hmbusch/PCB-Designs/Pixel/etching-template/pixel.png

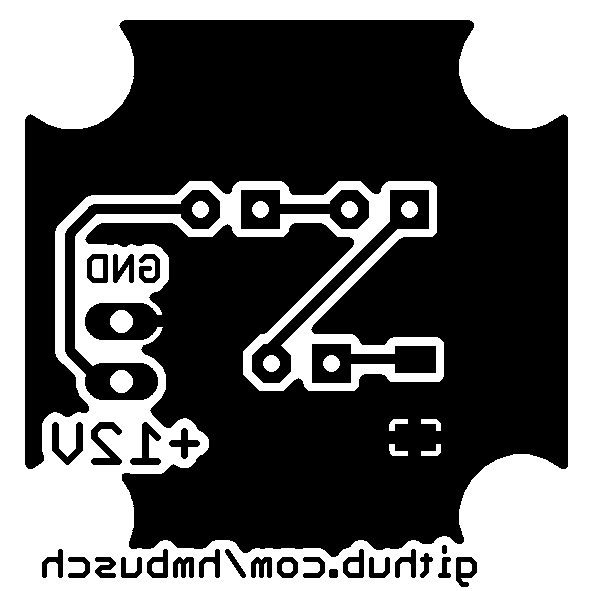
Pixel/etching-template/pixel.png
