hmbusch/PCB-Designs/SMD-Breakouts/images/g3528-plcc2-led-breakout.tif

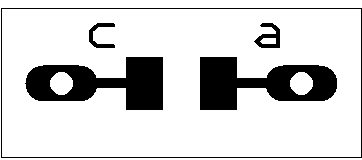
SMD-Breakouts/images/g3528-plcc2-led-breakout.tif
