hmbusch/PCB-Designs/SMD-Breakouts/images/so14-breakout.tif

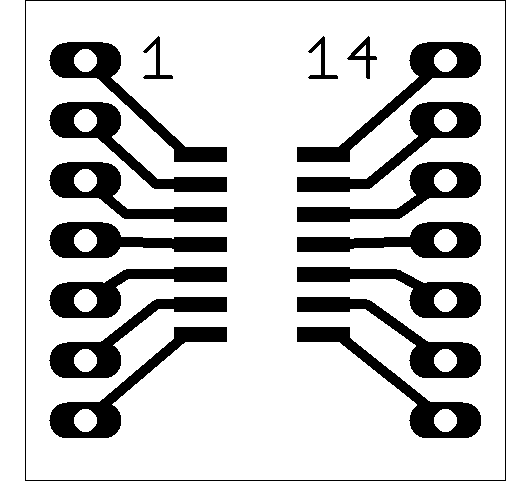
SMD-Breakouts/images/so14-breakout.tif
