hmbusch/PCB-Designs/kicad-3dmodels/alps-skrk-series-smd-push-button.step

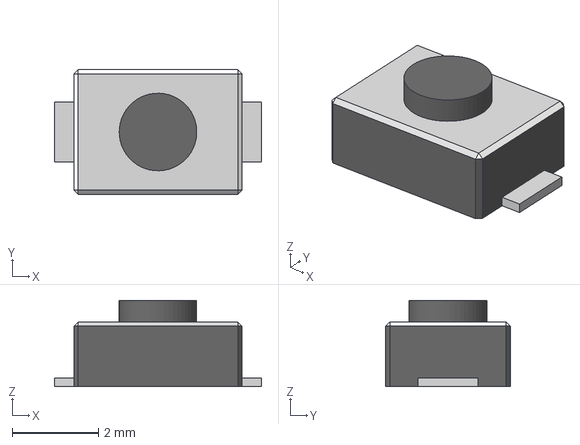
[picture p4: CAD file, 2024-10-26]
kicad-3dmodels/alps-skrk-series-smd-push-button.step
4.80 x 2.90 x 2.00 mm
