hmbusch/PCB-Designs/ChainableScrew595/ChainableScrew595.pdf

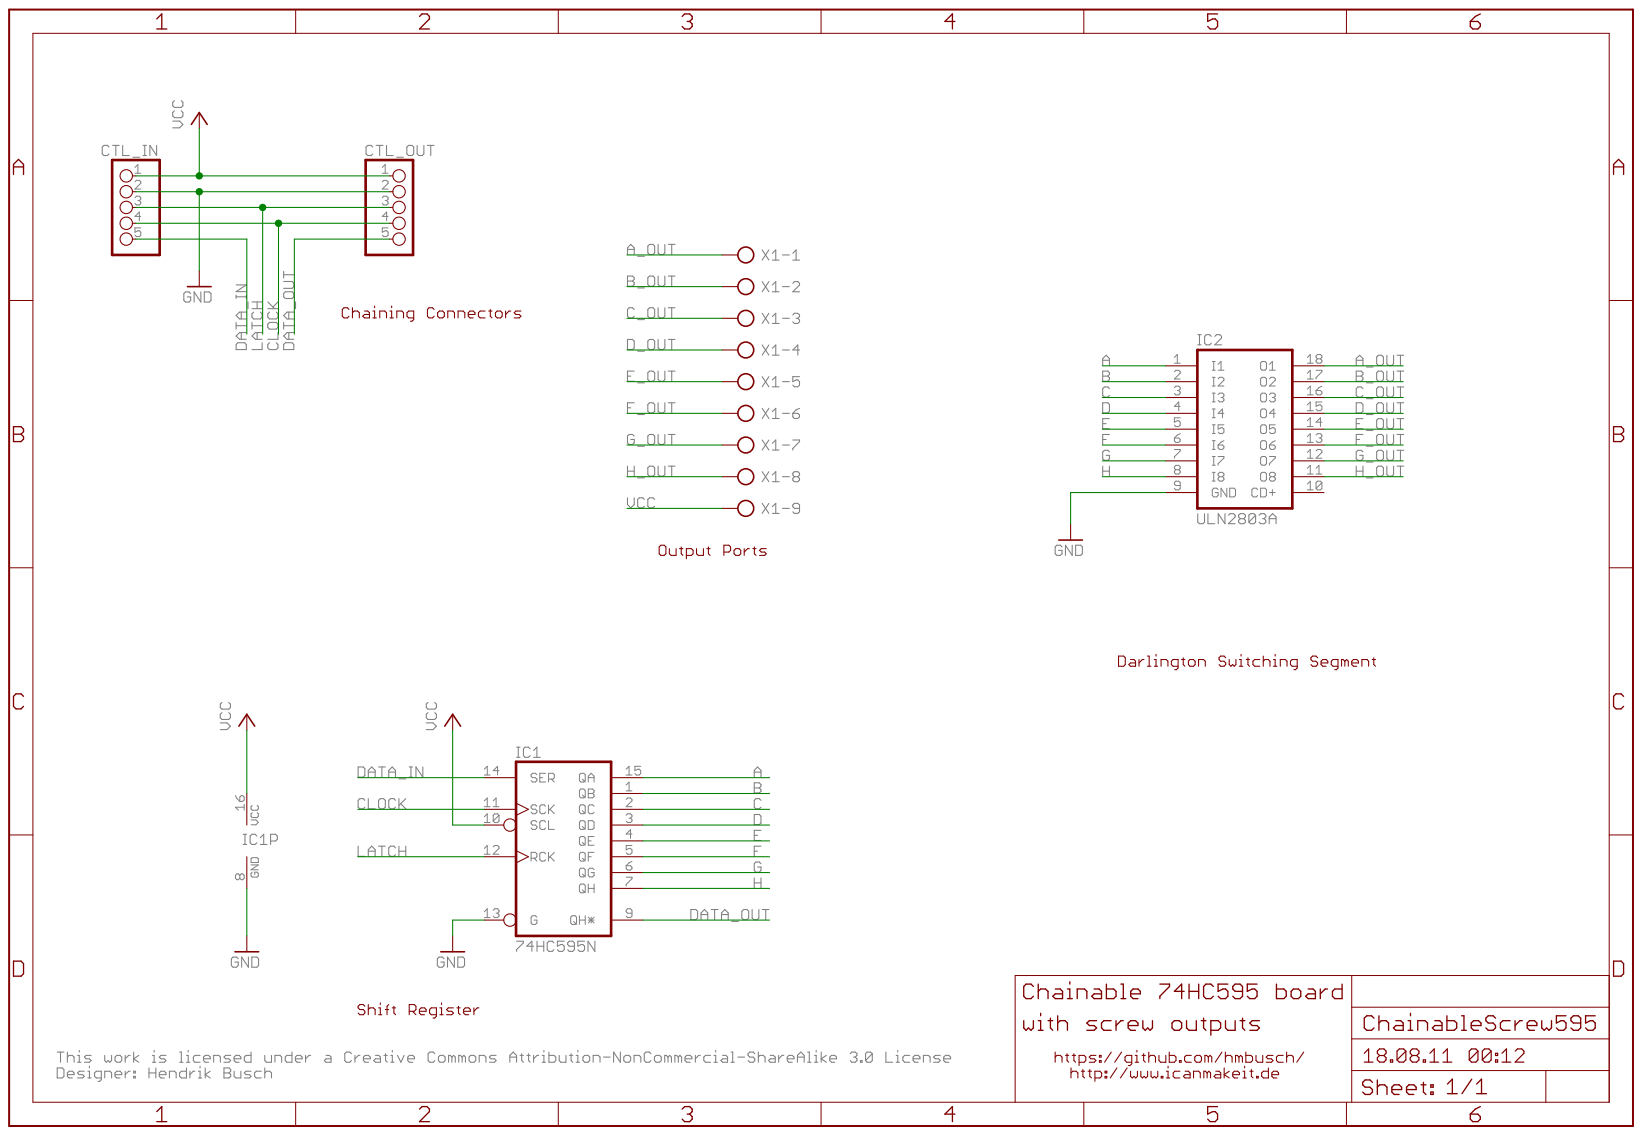
[picture p5: page 1]
