hmbusch/PCB-Designs/wemos-d1-mini-mainboard/wemos-d1-mini-mainboard.kicad_pcb

## KiCad design wemos-d1-mini-mainboard/wemos-d1-mini-mainboard.kicad_pcb (2023-09-02)

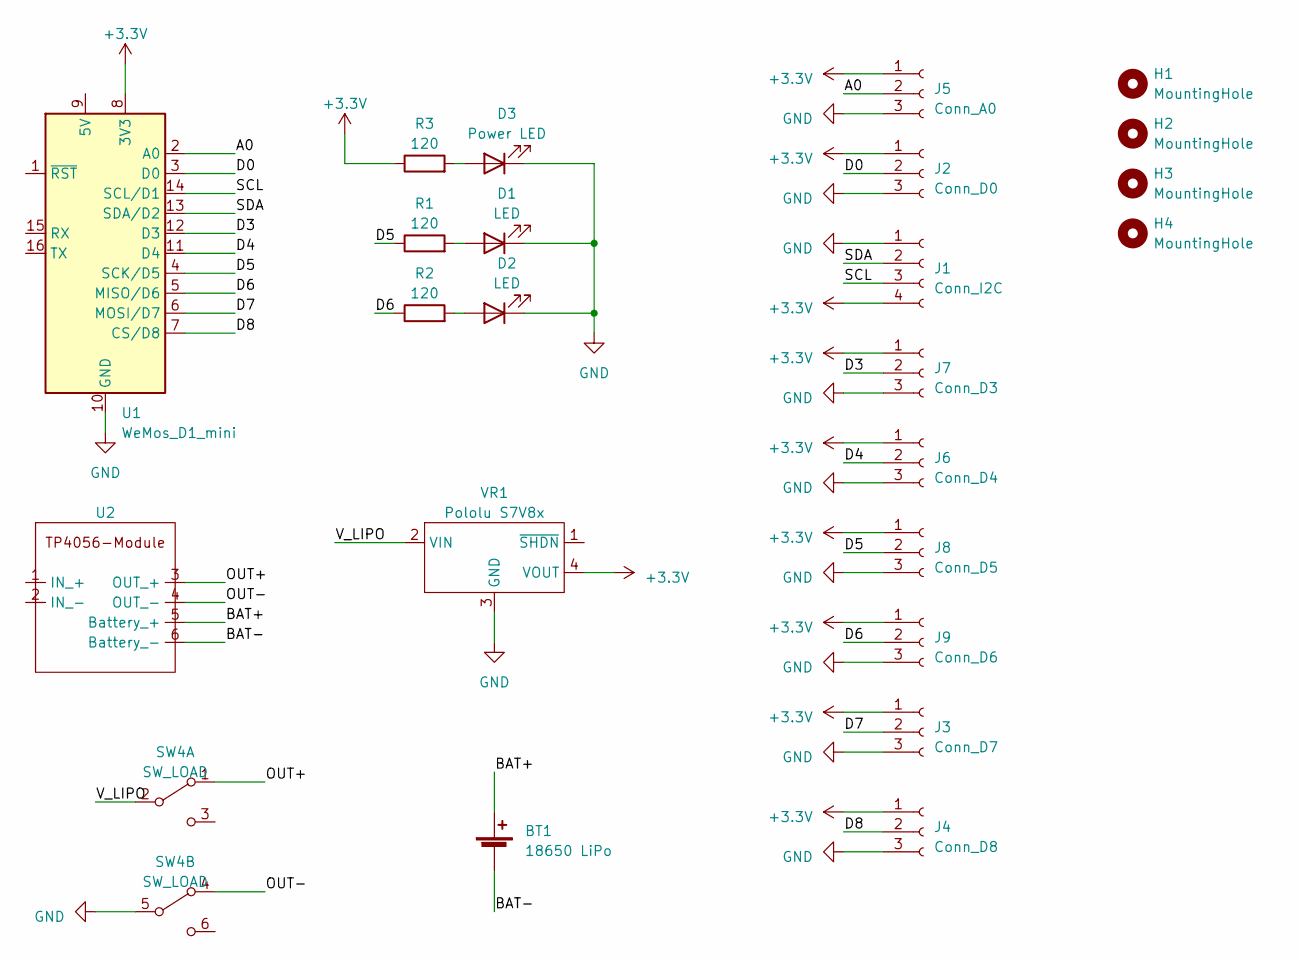
[picture p6: schematic wemos-d1-mini-mainboard.kicad_sch]

Parts:
BT1: 18650 LiPo; BatteryHolder_Keystone_1042_1x18650_different_silkscreen
D1, D2: LED; LED_SMD_3528_1411
D3: Power LED; LED_SMD_3528_1411
H1, H2, H3, H4: MountingHole; MountingHole_3.2mm_M3
J1: Conn_I2C; Molex_KK-254_AE-6410-04A_1x04_P2.54mm_Vertical
J2: Conn_D0; Molex_KK-254_AE-6410-03A_1x03_P2.54mm_Vertical
J3: Conn_D7; Molex_KK-254_AE-6410-03A_1x03_P2.54mm_Vertical
J4: Conn_D8; Molex_KK-254_AE-6410-03A_1x03_P2.54mm_Vertical
J5: Conn_A0; Molex_KK-254_AE-6410-03A_1x03_P2.54mm_Vertical
J6: Conn_D4; Molex_KK-254_AE-6410-03A_1x03_P2.54mm_Vertical
J7: Conn_D3; Molex_KK-254_AE-6410-03A_1x03_P2.54mm_Vertical
J8: Conn_D5; Molex_KK-254_AE-6410-03A_1x03_P2.54mm_Vertical
J9: Conn_D6; Molex_KK-254_AE-6410-03A_1x03_P2.54mm_Vertical
R1, R2, R3: 120; R_1206_3216Metric_Pad1.30x1.75mm_HandSolder
SW4: SW_LOAD; SK22D07_DPDT_slide_switch
U1: WeMos_D1_mini; WEMOS_D1_mini_light
U2: TP4056-Module
VR1: Pololu S7V8x; Pololu S7V8x Voltage Regulator

Connections:
+3.3V: J1.4, J2.1, J3.1, J4.1, J5.1, J6.1, J7.1, J8.1, J9.1, R3.1, U1.8 (3V3), VR1.4 (VOUT)
/A0: J5.2, U1.2 (A0)
/BAT+: BT1.1 (+), U2.5 (Battery_+)
/BAT-: BT1.2 (-), U2.6 (Battery_-)
/D0: J2.2, U1.3 (D0)
/D3: J7.2, U1.12 (D3)
/D4: J6.2, U1.11 (D4)
/D5: J8.2, R1.1, U1.4 (SCK/D5)
/D6: J9.2, R2.1, U1.5 (MISO/D6)
/D7: J3.2, U1.6 (MOSI/D7)
/D8: J4.2, U1.7 (CS/D8)
/OUT+: SW4.1 (A), U2.3 (OUT_+)
/OUT-: SW4.4 (A), U2.4 (OUT_-)
/SCL: J1.3, U1.14 (SCL/D1)
/SDA: J1.2, U1.13 (SDA/D2)
/V_LIPO: SW4.2 (B), VR1.2 (VIN)
GND: D1.1 (K), D2.1 (K), D3.1 (K), J1.1, J2.3, J3.3, J4.3, J5.3, J6.3, J7.3, J8.3, J9.3, SW4.5 (B), U1.10 (GND), VR1.3 (GND)
unnamed: D1.2 (A), R1.2
unnamed: D2.2 (A), R2.2
unnamed: D3.2 (A), R3.2

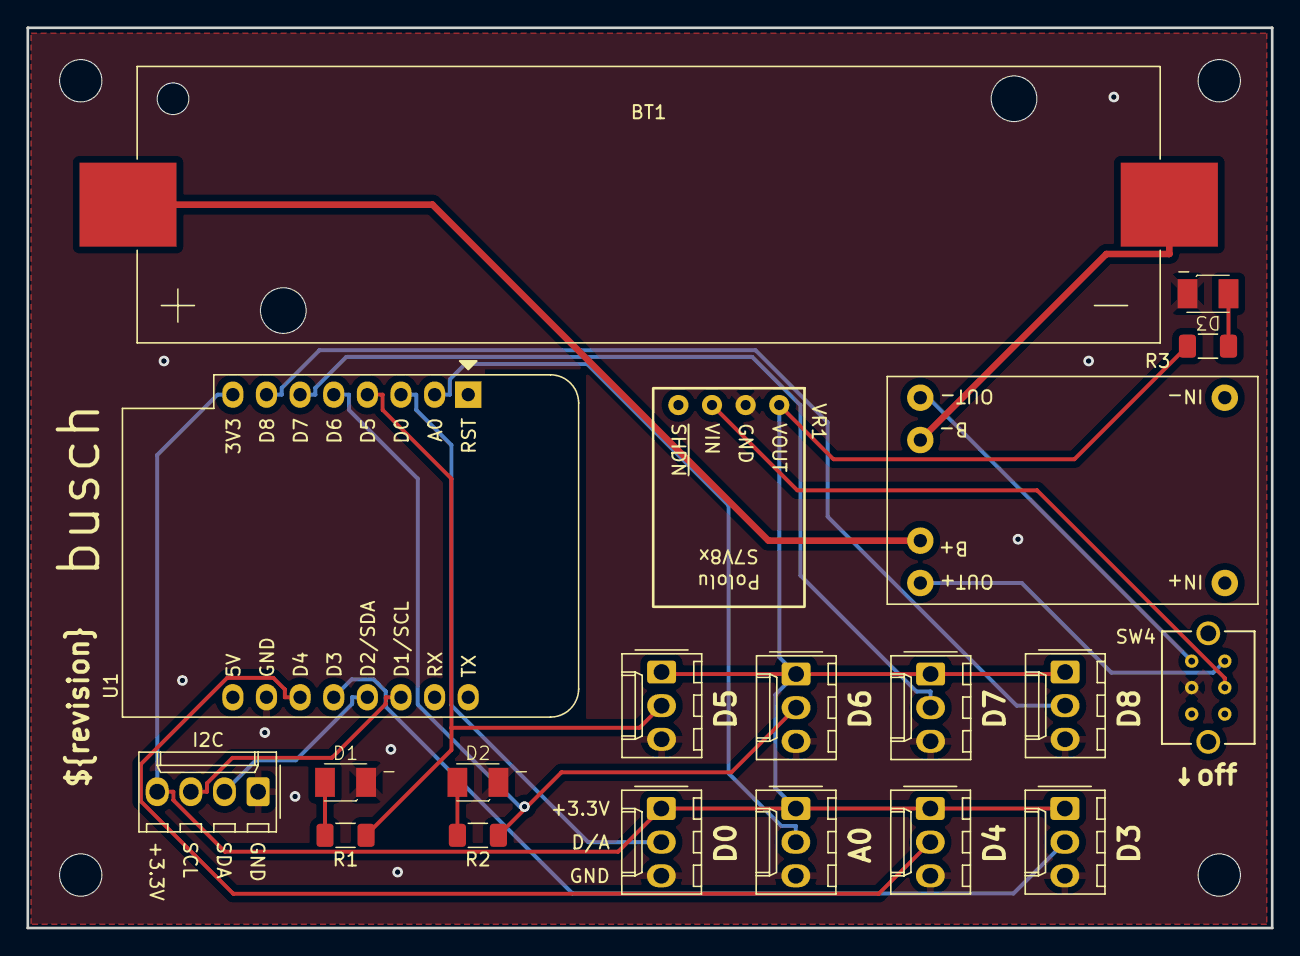
[picture p7: board wemos-d1-mini-mainboard.kicad_pcb from above]

Board: 2 copper layers, 94.0 x 68.0 mm, 24 parts (0 on the bottom side), 20 nets.
