hmbusch/PCB-Designs/Pixel/eagle-files/Pixel.brd

## EAGLE design old-designs/Pixel/eagle-files/Pixel.brd (2012-01-11, an earlier design)

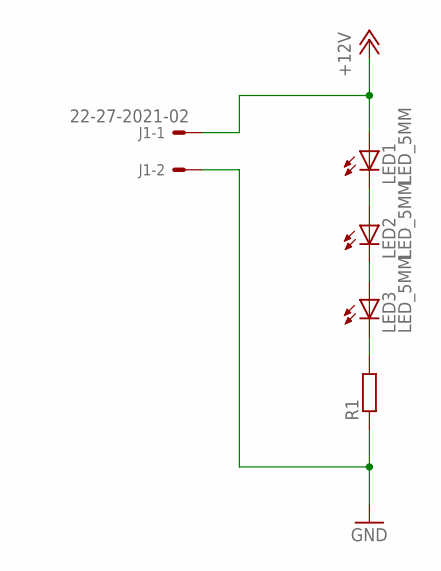
[picture p8: schematic Pixel.sch]

Parts:
J1: 22-27-2021-02; 6410-02
LED1, LED2, LED3: LED_5MM
R1: RESISTOR-1/4W-SMD-1206; R1206

Connections:
+12V: J1.1, LED1.ANODE
GND: J1.2, R1.P$1 (1)
unnamed: LED1.CATHODE, LED2.ANODE
unnamed: LED2.CATHODE, LED3.ANODE
unnamed: LED3.CATHODE, R1.P$2 (2)

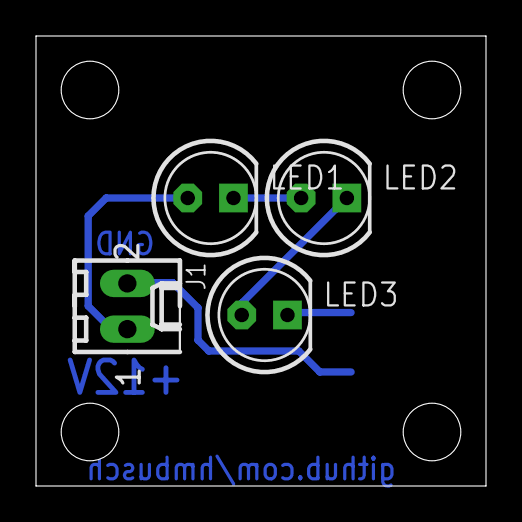
[picture p9: board Pixel.brd from above]

Board: 2 copper layers, 25.0 x 25.0 mm, 5 parts (1 on the bottom side), 5 nets.
