hmbusch/PCB-Designs/SMD-Breakouts/eagle-files/rfm69hcw-breakout.brd

## EAGLE design old-designs/SMD-Breakouts/eagle-files/rfm69hcw-breakout.brd (2014-11-12, an earlier design)

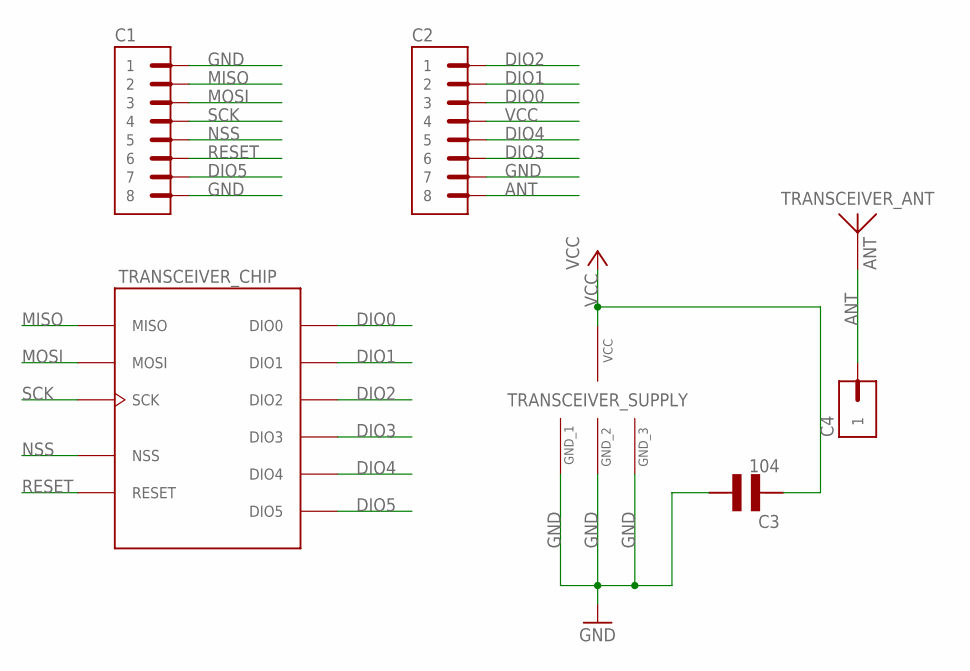
[picture p10: schematic rfm69hcw-breakout.sch]

Parts:
C1, C2: PIN_HEADER_8-WIDE; BREAKAWAY_STRAIGHT_8_WIDE
C3: 104; CERAMIC_CAP_5MM
C4: PIN_HEADER_1-WIDE; BREAKAWAY_STRAIGHT_1_WIDE
TRANSCEIVER: RFM69HCW-S2; HOPE-RF-16

Connections:
ANT: C2.8, C4.1, TRANSCEIVER.ANT
DIO0: C2.3, TRANSCEIVER.DIO0
DIO1: C2.2, TRANSCEIVER.DIO1
DIO2: C2.1, TRANSCEIVER.DIO2
DIO3: C2.6, TRANSCEIVER.DIO3
DIO4: C2.5, TRANSCEIVER.DIO4
DIO5: C1.7, TRANSCEIVER.DIO5
GND: C1.1, C1.8, C2.7, C3.P$2, TRANSCEIVER.GND1 (GND_1), TRANSCEIVER.GND2 (GND_2), TRANSCEIVER.GND3 (GND_3)
MISO: C1.2, TRANSCEIVER.MISO
MOSI: C1.3, TRANSCEIVER.MOSI
NSS: C1.5, TRANSCEIVER.NSS
RESET: C1.6, TRANSCEIVER.RESET
SCK: C1.4, TRANSCEIVER.SCK
VCC: C2.4, C3.P$1, TRANSCEIVER.3.3V (VCC)

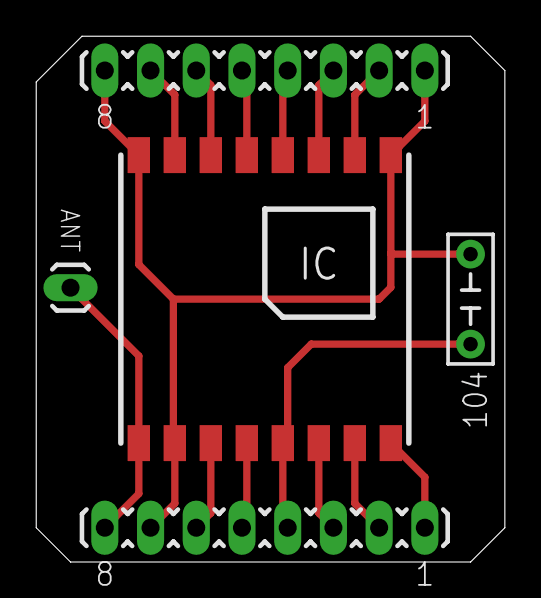
[picture p11: board rfm69hcw-breakout.brd from above]

Board: 2 copper layers, 26.0 x 29.2 mm, 5 parts (0 on the bottom side), 14 nets.
