hmbusch/PCB-Designs/SMD-Breakouts/eagle-files/g3528-plcc2-led-breakout.brd

## EAGLE design old-designs/SMD-Breakouts/eagle-files/g3528-plcc2-led-breakout.brd (2012-06-03, an earlier design)

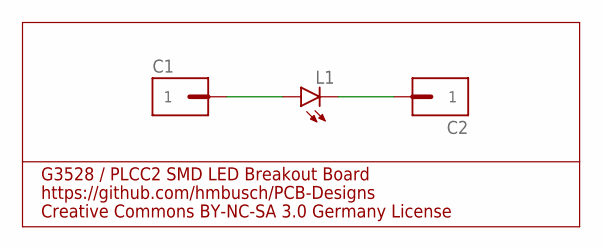
[picture p12: schematic g3528-plcc2-led-breakout.sch]

Parts:
C1, C2: PIN_HEADER_1-WIDE; BREAKAWAY_STRAIGHT_1_WIDE
L1: LED-G3528; G3528

Connections:
unnamed: C1.1, L1.A (ANODE)
unnamed: C2.1, L1.C (CATHODE)

Notes on the sheet:
G3528 / PLCC2 SMD LED Breakout Board
https://github.com/hmbusch/PCB-Designs
Creative Commons BY-NC-SA 3.0 Germany License

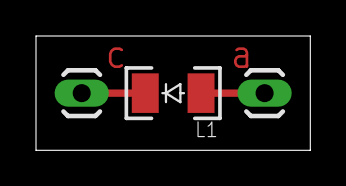
[picture p13: board g3528-plcc2-led-breakout.brd from above]

Board: 2 copper layers, 15.2 x 6.3 mm, 3 parts (0 on the bottom side), 2 nets.
