hmbusch/PCB-Designs/Max7219Breakout/eagle-files/max7219_breakout.brd

## EAGLE design old-designs/Max7219Breakout/eagle-files/max7219_breakout.brd (2012-05-26, an earlier design)

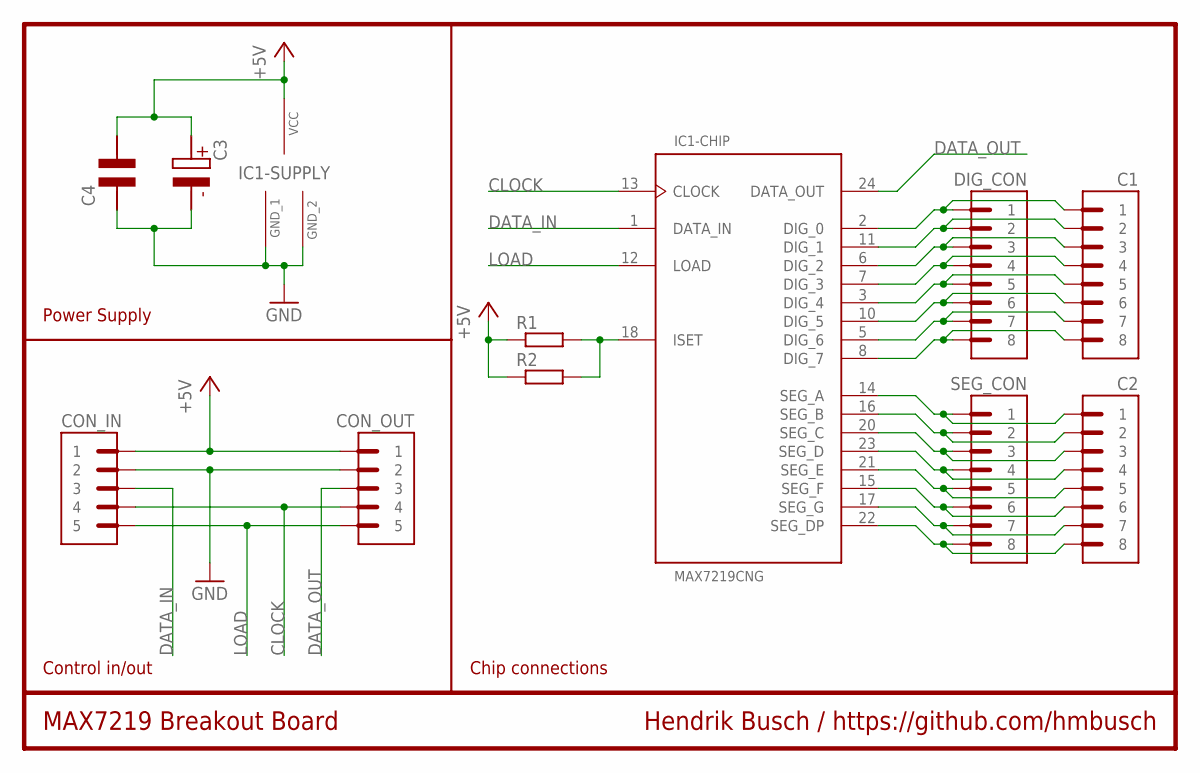
[picture p14: schematic max7219_breakout.sch]

Parts:
C1, C2: PIN_HEADER_8-SCREW-TERMINAL; TERMINAL_BLOCK_8
C3: CAPACITOR_POLARIZED-5X5-2.0; CAP_POL_5X5_2
C4: CAPACITOR-CERAMIC-5MM; CERAMIC_CAP_5MM
CON_IN: PIN_HEADER_5-WIDE; BREAKAWAY_STRAIGHT_5_WIDE
CON_OUT: PIN_HEADER_5-WIDE; BREAKAWAY_STRAIGHT_5_WIDE
DIG_CON: PIN_HEADER_8-WIDE; BREAKAWAY_STRAIGHT_8_WIDE
IC1: MAX7219CNG; DIP-24
R1, R2: RESISTOR-1/4W-12.7-AXIAL; RESISTOR-1/4W-AXIAL
SEG_CON: PIN_HEADER_8-WIDE; BREAKAWAY_STRAIGHT_8_WIDE

Connections:
+5V: C3.A, C4.P$2, CON_IN.1, CON_OUT.1, IC1.19 (VCC), R1.P$1 (1), R2.P$1 (1)
CLOCK: CON_IN.4, CON_OUT.4, IC1.13 (CLOCK)
DATA_IN: CON_IN.3, IC1.1 (DATA_IN)
DATA_OUT: CON_OUT.3, IC1.24 (DATA_OUT)
DIG_0: C1.P$1 (1), DIG_CON.1, IC1.2 (DIG_0)
DIG_1: C1.P$2 (2), DIG_CON.2, IC1.11 (DIG_1)
DIG_2: C1.P$3 (3), DIG_CON.3, IC1.6 (DIG_2)
DIG_3: C1.P$4 (4), DIG_CON.4, IC1.7 (DIG_3)
DIG_4: C1.P$5 (5), DIG_CON.5, IC1.3 (DIG_4)
DIG_5: C1.P$6 (6), DIG_CON.6, IC1.10 (DIG_5)
DIG_6: C1.P$7 (7), DIG_CON.7, IC1.5 (DIG_6)
DIG_7: C1.P$8 (8), DIG_CON.8, IC1.8 (DIG_7)
GND: C3.C, C4.P$1, CON_IN.2, CON_OUT.2, IC1.4 (GND_1), IC1.9 (GND_2)
LOAD: CON_IN.5, CON_OUT.5, IC1.12 (LOAD)
unnamed: IC1.18 (ISET), R1.P$2 (2), R2.P$2 (2)
SEG_A: C2.P$1 (1), IC1.14 (SEG_A), SEG_CON.1
SEG_B: C2.P$2 (2), IC1.16 (SEG_B), SEG_CON.2
SEG_C: C2.P$3 (3), IC1.20 (SEG_C), SEG_CON.3
SEG_D: C2.P$4 (4), IC1.23 (SEG_D), SEG_CON.4
SEG_DP: C2.P$8 (8), IC1.22 (SEG_DP), SEG_CON.8
SEG_E: C2.P$5 (5), IC1.21 (SEG_E), SEG_CON.5
SEG_F: C2.P$6 (6), IC1.15 (SEG_F), SEG_CON.6
SEG_G: C2.P$7 (7), IC1.17 (SEG_G), SEG_CON.7

Notes on the sheet:
Power Supply
Control in/out
Chip connections
MAX7219 Breakout Board
Hendrik Busch / https://github.com/hmbusch

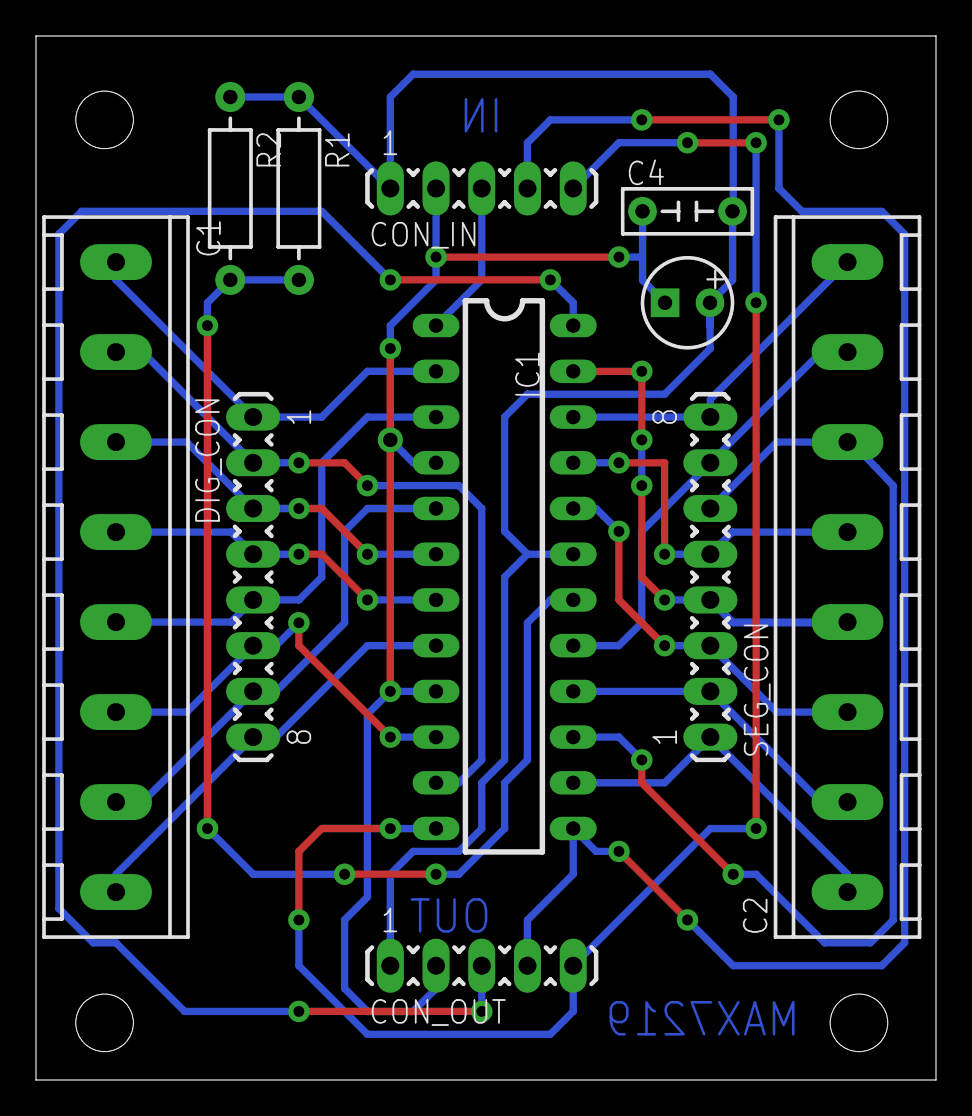
[picture p15: board max7219_breakout.brd from above]

Board: 2 copper layers, 50.0 x 58.0 mm, 11 parts (0 on the bottom side), 23 nets.
