hmbusch/PCB-Designs/SMD-Breakouts/eagle-files/so14-breakout.brd

## EAGLE design old-designs/SMD-Breakouts/eagle-files/so14-breakout.brd (2012-06-03, an earlier design)

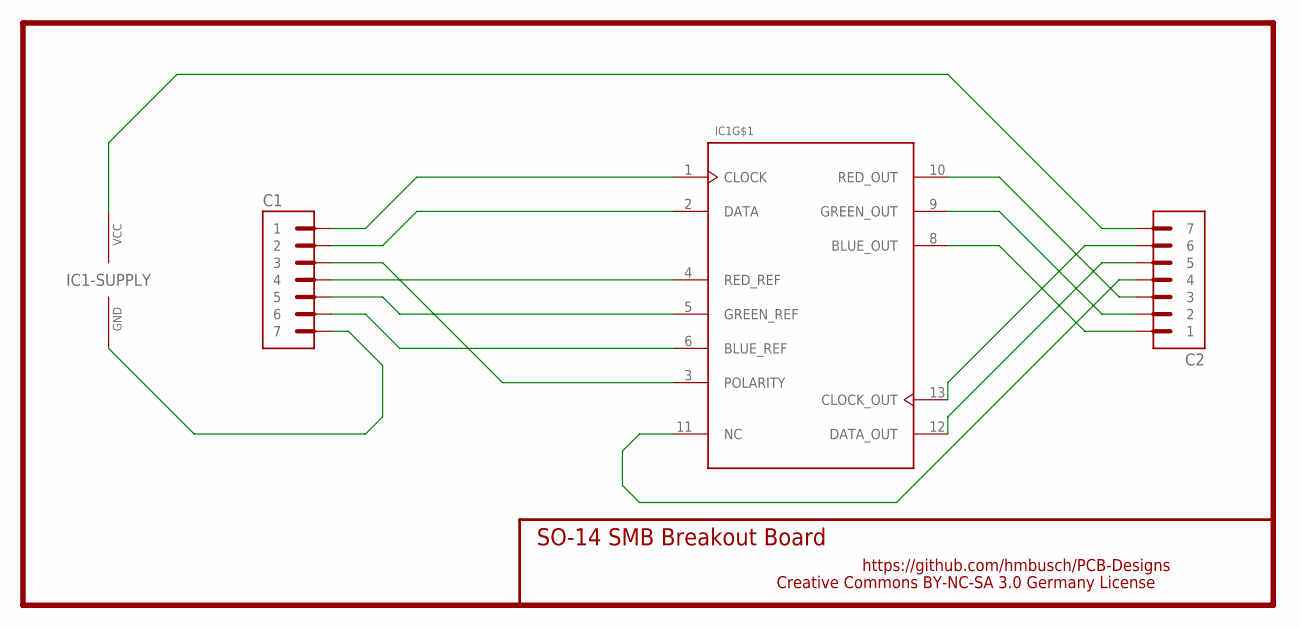
[picture p16: schematic so14-breakout.sch]

Parts:
C1, C2: PIN_HEADER_7-WIDE; BREAKAWAY_STRAIGHT_7_WIDE
IC1: WS2801-SO14; SO-14

Connections:
GND: C1.7, IC1.7 (GND)
unnamed: C1.1, IC1.1 (CLOCK)
unnamed: C1.2, IC1.2 (DATA)
unnamed: C1.3, IC1.3 (POLARITY)
unnamed: C1.4, IC1.4 (RED_REF)
unnamed: C1.5, IC1.5 (GREEN_REF)
unnamed: C1.6, IC1.6 (BLUE_REF)
unnamed: C2.1, IC1.8 (BLUE_OUT)
unnamed: C2.2, IC1.9 (GREEN_OUT)
unnamed: C2.3, IC1.10 (RED_OUT)
unnamed: C2.5, IC1.12 (DATA_OUT)
unnamed: C2.6, IC1.13 (CLOCK_OUT)
unnamed: C2.7, IC1.14 (VCC)
unnamed: C2.4, IC1.11 (NC)

Notes on the sheet:
SO-14 SMB Breakout Board
https://github.com/hmbusch/PCB-Designs
Creative Commons BY-NC-SA 3.0 Germany License

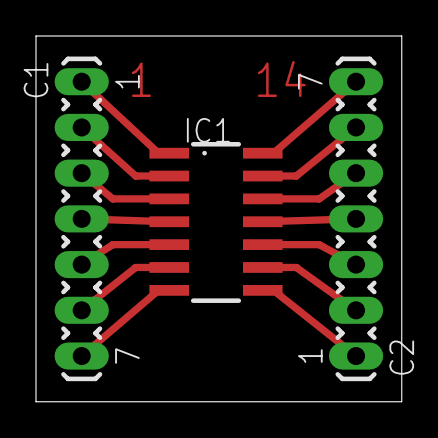
[picture p17: board so14-breakout.brd from above]

Board: 2 copper layers, 20.3 x 20.3 mm, 3 parts (0 on the bottom side), 14 nets.
