hmbusch/PCB-Designs/(commit log)

2011-08-17 First checkin of completed design
    [ChainableScrew595.brd, ChainableScrew595.sch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]
2012-01-03 Added 2N7002 SMD MOSFET and 1/4W resistor with axial and SMD package. Cleaned up some of the other components with regard to labels, layers, etc.
2012-01-03 Created a small 595-based pixel bar. Schematics and board are first draft only.
    [PixelBar-w6Pixels.brd, PixelBar-w6Pixels.sch]
2012-01-11 Added a very small PCB that carries 3 5mm LEDs to create a larger "pixel" from common high brightness LEDs instead of Power LEDs.
    [Pixel.brd, Pixel.sch]
2012-01-11 Rearranged files for better overview.
    [Pixel.brd, Pixel.sch]
2012-01-11 Scrapped the idea of one large pixel bar in favorite of individual 3-LED pixels. Also, the freeware version of Eagle limits the board size and the board is thus too small for the led bar.
    [PixelBar-w6Pixels.brd, PixelBar-w6Pixels.sch]
2012-01-11 Added 3mm, 5mm and 10mm LEDs
2012-02-21 Added symbols for two-digit seven segment displays. Added a package for older Kingbright Dx04 Dual Digit Numeric Displays. Added a device for Kingbright DA04-11 displays.
2012-02-23 Added SMD footprints for the HopeRF RFM01 and RFM02 modules. RFM01 is the ISM band FSK receiver, RFM02 is the ISM band FSK transmitter. Both modules are sold in Germany by Pollin.
2012-02-25 Added >NAME and >VALUE labels to the seven segment packages and symbols. Also added a drill hole for the potentiometer.
2012-02-27 - Added a DIP/DIL-16 package - Added a symbold and device for 74x4017 ICs - Added various PWR/GND combinations for use as a separate symbol in IC devices - Added an antenna symbol and pin - Removed P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
2012-03-08 Moved the seven-segment package pins onto a 0.1 inch grid for better signal routing. The MOSFET pin descriptions were switched onto another layer to make them appear by default in the schematics.
2012-03-10 - Added the SO-16 package and a 74x4017 variant with SO-16 package - Added several new breakaway pin header packages and unified the labeling - Deleted all custom layers since they are not needed - A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
2012-03-15 Added the DIP-18 package and created the symbol and device for the ULN2803 Darlington Array
2012-03-15 - Added the 74*595 shift register with two packages - Active low pins on ICs are now designated as such - Enabled user value on the resistor device - Added devices for 5-pin and 8-pin headers
2012-03-15 Completed the first version of a 8-digit seven segment board using a decade counter and a shift register as driver. Some components use SMD packages for smaller board size.
    [simple-8-digit-connector-board.sch]
2012-03-20 After the first (desastrously failed) attempt to layout the seven segment PCB, the second approach looks more promising so far.
    [simple-8-digit-connector-board.sch]
2012-03-20 Added the SOIC-18-W package, plastic small outline 18-lead wide body (0.3 in/0.7 mm) package and created a new variant for the ULN280x device, using the new package.
2012-03-20 Added the backups of the PCB layout to the ignored files.
2012-03-20 Hmm, this was supposed to be the commit regarding the second try on layouting the PCB. So, here it goes: the is the first step of the second try of layouting the PCB and it looks more promising so fa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
    [simple-8-digit-connector-board.brd]
2012-03-20 Added the autorouter logfile to the list of ignored files. In this project, the autorouter doesn't seem to do much good anyway and it looks like I'm better off routing the PCB by hand.
2012-03-21 Assigned a proper name to a few more signals to make the layouting process easier (proper names enable precise filtering with the RATSNEST command)
    [simple-8-digit-connector-board.sch]
2012-03-21 Started all over again, this time with a 2-layer PCB intended for professional manufacturing. Trying to squeeze SMD components and 'wire-intensive' parts like seven-segment displays on a single-sided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
    [simple-8-digit-connector-board.brd]
2012-03-21 Fixed problem with the wide pin header packages where the silkscreen would overlap the solder pads. Added an 8-pin angled connector package.
2012-03-21 Fixed stupid bug in the circuit design: The digit anodes were all switched per seven-segment part, i.e. digit 1 was connected to the decade counter line 2 and digit 2 to decade counter line 1, and so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
    [simple-8-digit-connector-board.sch]
2012-03-21 Finished the 2-layer PCB layout. Now all thats missing is a ground plane and some labeling.
    [simple-8-digit-connector-board.brd]
2012-03-21 Finalized the PCB layout by adding label, ground planes and mounting holes.
    [simple-8-digit-connector-board.brd]
2012-03-25 Duplicated some of the labels onto the bottom silkscreen layer. Especially the pin labeling is useful.
    [simple-8-digit-connector-board.brd]
2012-04-07 Added PLCC6 package and RGB LED using this package
2012-04-09 Added 4- and 6-pin headers
2012-04-09 Increased drill size on headers from .8mm to 1mm
    The drill size on the breakaway header packages was too small to actually
    fit any such header. D'oh! Increased the drill size to 1mm and adjusted
    the silkscreen markings accordingly.
2012-04-09 Created gerber files for project
    The design was translated to gerber files using the CAM job configuration
    from Seeed Studio for their Fusion PCB service. The job generated a lot
    more files, but Fusion PCB only needs those added now.
    [SevenSegmentBoard.GBL, SevenSegmentBoard.GBO, SevenSegmentBoard.GBS, SevenSegmentBoard.GTL, SevenSegmentBoard.GTO, SevenSegmentBoard.GTS]
2012-04-09 New (correct) 8-pin connector and level fix for some labels.
    Replaced the 8-pin connector with the fixed version from the library (w/
    larger pads and 1mm drill size instead of .8mm). Had to rearrange some
    wires and labels. The bottom labels were accidentally placed on bPlace
    instead of bNames, this is now also fixed.
    [simple-8-digit-connector-board.brd, simple-8-digit-connector-board.sch]
2012-04-09 Created a new library just for connectors.
    Since the content of a single library tends to get a little chaotic, I
    have decided t split the library by component group. This first new
    library contains all connectors specified so far. These have been moved
    from the general library to the new one.
2012-04-19 Added new packages for locking pin connectors, renamed the 90� packages.
    Specifications for locking headers taken from W�rth Elektronik datasheet
    for the WR-WTB 2.54mm header series
    (http://katalog.we-online.de/kataloge/eican/index.php?language=en&pf=619_0xx_110_21).
2012-04-19 Added diode symbol, DO-35 and DO-41 packages and 1N4148 and 1N4001 diodes.
2012-04-20 Added a small selection of WIMA MKS-2 film capacitors.
2012-04-23 Fixed serious bug: the register's CLEAR pin is now pulled high instead of low.
    The CLEAR pin of the 74HC595 was accidentally connected to ground,
    pulling it low and thereby active all the time, preventing the register
    from working normally. It is now pulled to high and thereby inactive,
    allowing normal operation.
    The board now bears the version 1.1. The board has been updated to use the
    parts from the new sub-libraries. The last throughole resister has been
    replaced with an 1206 surface mount version. The lower right mounting has
    been moved to the left of the connector and can now actually be used even
    with a locking connector attached.
    All of the writing is now on the appropriate layer.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
    [simple-8-digit-connector-board.brd, simple-8-digit-connector-board.sch]
2012-05-06 Moved all LED components (inlcuding seven-segment) to a dedicated library file.
2012-05-06 Started work on a library for voltage regulators.
    So far not much to see except for the TO-220 package.
2012-05-06 Created the G3528 (3.5x2.8mm) LED SMD package and added a new LED variant.
2012-05-16 Created a new library for integrated circuits and moved all IC devices and packages from the old main library to this new one
2012-05-17 Added throughhole variant of the RGB LED, using common anode
2012-05-18 Added screw type terminal blocks with various pin counts
2012-05-18 Added electrolytic capacitor modelled after Yageo's S5 series, 35V, 10uF, 5x5mm can size
2012-05-19 Created a breakout board for the MAX7219 chip.
    This board features a MAX7219 chip, stabilizing capacitors as suggested by
    the datasheet, voltage divider resistors for setting the maximum segment
    current and 4 reordered connectors, one for digits, one for segment, one
    control input and one control output to daisy chain multiple breaktout
    boards. The digit and segment connectors offer footprints for pin headers
    and screw type block terminals.
    [max7219_breakout.brd, max7219_breakout.sch]
2012-05-22 Removed silkscreen overlap on the 3-pin connector.
2012-05-22 Optimized the 2N7000 MOSFET component by rearranging some label, making the value user definable and adding a common prefix.
2012-05-22 Removed silkscreen overlap on SMD resistor
2012-05-22 The Seven-Segment Board has been moved to its own repository at https://github.com/hmbusch/ICMI-SevenSegmentBoard
    [simple-8-digit-connector-board.brd, simple-8-digit-connector-board.sch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]
2012-05-26 Added pin headers with one and seven pins (mainly for breakouts)
2012-05-26 Had to redesign the board because the DIP-24 package was too wide and the vias were too small for hand drilling.wq
    [max7219_breakout.brd, max7219_breakout.sch]
2012-06-03 Added two small SMD breakout board, one for SOP-14 SMD ICs, the other one for G3528 / PLCC2 SMD LEDs
    [g3528-plcc2-led-breakout.brd, g3528-plcc2-led-breakout.sch, so14-breakout.brd, so14-breakout.sch]
2012-06-08 Added FTDIs FT232R USB/UART IC and the impossible SSOP28 package
2014-11-12 Assigned correct name to non-polarizes capacitors
2014-11-12 Created a breakout board for the HopeRF RFM69HCW
    [rfm69hcw-breakout.brd, rfm69hcw-breakout.sch]
2016-07-11 Added the Pololu S7V8F3 3.3V step up/down voltage regulator
2016-07-11 Added 1S LiPo BMS/charger module
    The small modules found on ebay featuring a Micro-USB
    port, A TP4056 charge controller and a DW01 cell
    protection IC.
2016-07-21 Added new 10x13mm (5mm pitch) package for polarized caps
2016-07-21 Removed some unneccessary wires
2016-08-14 New Adafruit HUZZAH package without mounts
    Created a new package with the mounting posts
    removed. This allows for more space to lay down
    signal lines when using the regular connector
    posts to mount the board.
2023-08-22 Moved all the old stuff over for new design
    No one wants to see 10 year old designs and libraries for PCB
    design software that has been integrated into Fusion360 and is
    only available through paid subscription.
    New design will be added next.
    [ChainableScrew595.brd, ChainableScrew595.sch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]
2023-08-22 Wemos D1 Mainboard v1.0 added
    See README.md for more details on this design.
    [wemos-d1-mini-mainboard.kicad_pcb, wemos-d1-mini-mainboard.kicad_sch]
2023-08-22 Added folder for KiCad 3D models
    There is a 3D model of the TP4056 module available under
    https://kicadrookie.blogspot.com/2022/01/tp4056-module-kicad-3d-asset.html
    that I have not included for copyright reasons.
    If you intend to download it, the scale modifier when importing
    into KiCad is 0.393 for all three axes.
2023-08-22 Added folder for KiCad 3D models
    I initially added a 3D model for the TP4056 module, but it was
    not created by me, so I omitted it due to copyright reasons. It
    can be downloaded from:
    If you choose to download it, the scaling factor for all three
    axes when importing into KiCad seems to be 0.393.
    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
2023-08-24 Wemos D1 Mainboard: changed LEDs to 1210 footprint
    1210 is a bit more versatile and is actually the LED component
    size I have in stock.
    The board had to be rerouted, so there a lot of actual file
    changes.
    [wemos-d1-mini-mainboard.kicad_pcb, wemos-d1-mini-mainboard.kicad_sch]
2023-09-01 Wemos D1 Mini Mainboard: Added hardware test sketch
    I added a small sketch that verifies the correct assembly
    of the PCB. Currently, it only blinks the two LEDs attached
    to D5 and D6.
    [wemos-d1-mini-mainboard-hardware-test.ino]
2023-09-02 Kicad: Added footprint for 3528 / 1411 PLCC2 LED
    Kicad seems only to contain either footprints that are a little to
    small for 3528/1411 or are asymmetrical, where one pad is almost
    double in size compared to the other. My SMD LEDs don't reflect that,
    so I added my own footprint based on a Kingbright SMD LED datasheet.
2023-09-02 Kicad: Fixed TP4056 battery pin spacing
    The initial spacing between `OUT+` and `BAT+` and the corresponding
    negative pads was 2.54mm. This however, does not line up with any
    actual TP4056 module I own (Micro-USB and USB-C versions), the pins
    are spaced further apart. I updated the footprint to reflect that.
2023-09-02 Wemos D1 Mainboard: Fixed missing ground issues
    Version 1.0 and 1.1 had unconnected ground lines to the D5/D6 LEDs.
    This has now been fixed. There were also a few other changes:
    - Only the lines from the TP4056 module to the battery have a larger
    width than the other lines, as they need to carry 1A from the charger.
    The other power line widths have been reduced.
    - Small fix to the 3528 footprint silkscreen, the cathode marking and
    the pad keepout were overlapping.
    - Updated the TP4056 footprint to the one with the corrected pins
    spacings.
    [wemos-d1-mini-mainboard.kicad_pcb, wemos-d1-mini-mainboard.kicad_sch]
2023-09-25 Added several older dual seven segment displays (#8)
    * Added symbols/footprints for 4 older seven segment displays
    - Kingbright DA04/DC04 dual 10.2mm seven segment (common anode only)
    - Kingbright DC52/DA52 dual 13.2mm seven segment (common cathode only)
    - Oasistek TOD-4201FG-B dual 10.2mm seven segment (common anode)
    - RTF VQE 21 1.5x12.7mm seven segment (displays +1.8. when all segments
    are lit, and yes, this is the pre-1989 GDR part)
    3D models are accurate in size, but not always in pins (16 vs. 10) and
    also not in the digits they display (VQE is +1.8., not 8.8.)
2023-09-28 VQE 21: Fixed silkscreen, added 2nd version with less silkscreen (#9)
    The components silkscreen extended over the edge of the carrier
    PCB in one of my projects and since KiCAD currently has no trimming
    feature, I created a version with less silkscreen.
    Normally I wouldn't bother, but with panelization, you'll get silkscreen
    spill from one board into the adjacent one.
2023-11-10 Added symbols for A2331 and MX612E components (#10)
    - A2331 is a current limiting load switch
    - MX612E is a controller IC for brushed DC motors
2023-11-10 Reverse engineered schematic of a cheap watch winder PCB (#11)
    This is the schematic I reverse engineered from the control PCB
    of one of the cheap watch winders from Amazon/AliExpress where
    the PCB, DC socket and power switch form one combined part.
    There may be inaccuracies , especially regarding the microcontroller.
    The chosen PIC makes sense from a pinout and capabilities perspective,
    but it might be a different controller alltogether (markings had been
    removed).
    [watch-winder-reverse-engineering.kicad_pcb, watch-winder-reverse-engineering.kicad_sch]
2024-04-21 Added Kicad 8 cache folder to .gitignore
2024-04-21 Added KiCads cache folder to ignore file (#12)
2024-10-21 Updated files to KiCad 8
    [watch-winder-reverse-engineering.kicad_sch]
2024-10-21 Updated files to KiCad 8 (#13)
2024-10-26 Added footprint & 3D model for ALPS SKRK Series Push Button (#15)
    * Added footprint for ALPS SKRK Series Push Button
    See https://tech.alpsalpine.com/e/products/category/tact-switch/sub/02/series/skrk/
    for more details regarding this component.
    * Created 3D model for ALPS SKRK Button
    The model is correctly dimensioned but doesn't look graphically
    like the original button.
    [alps-skrk-series-smd-push-button.step]
